floresacton/usb-can/pcb/usb-can.kicad_pcb

## KiCad design pcb/usb-can.kicad_pcb (2025-09-29)

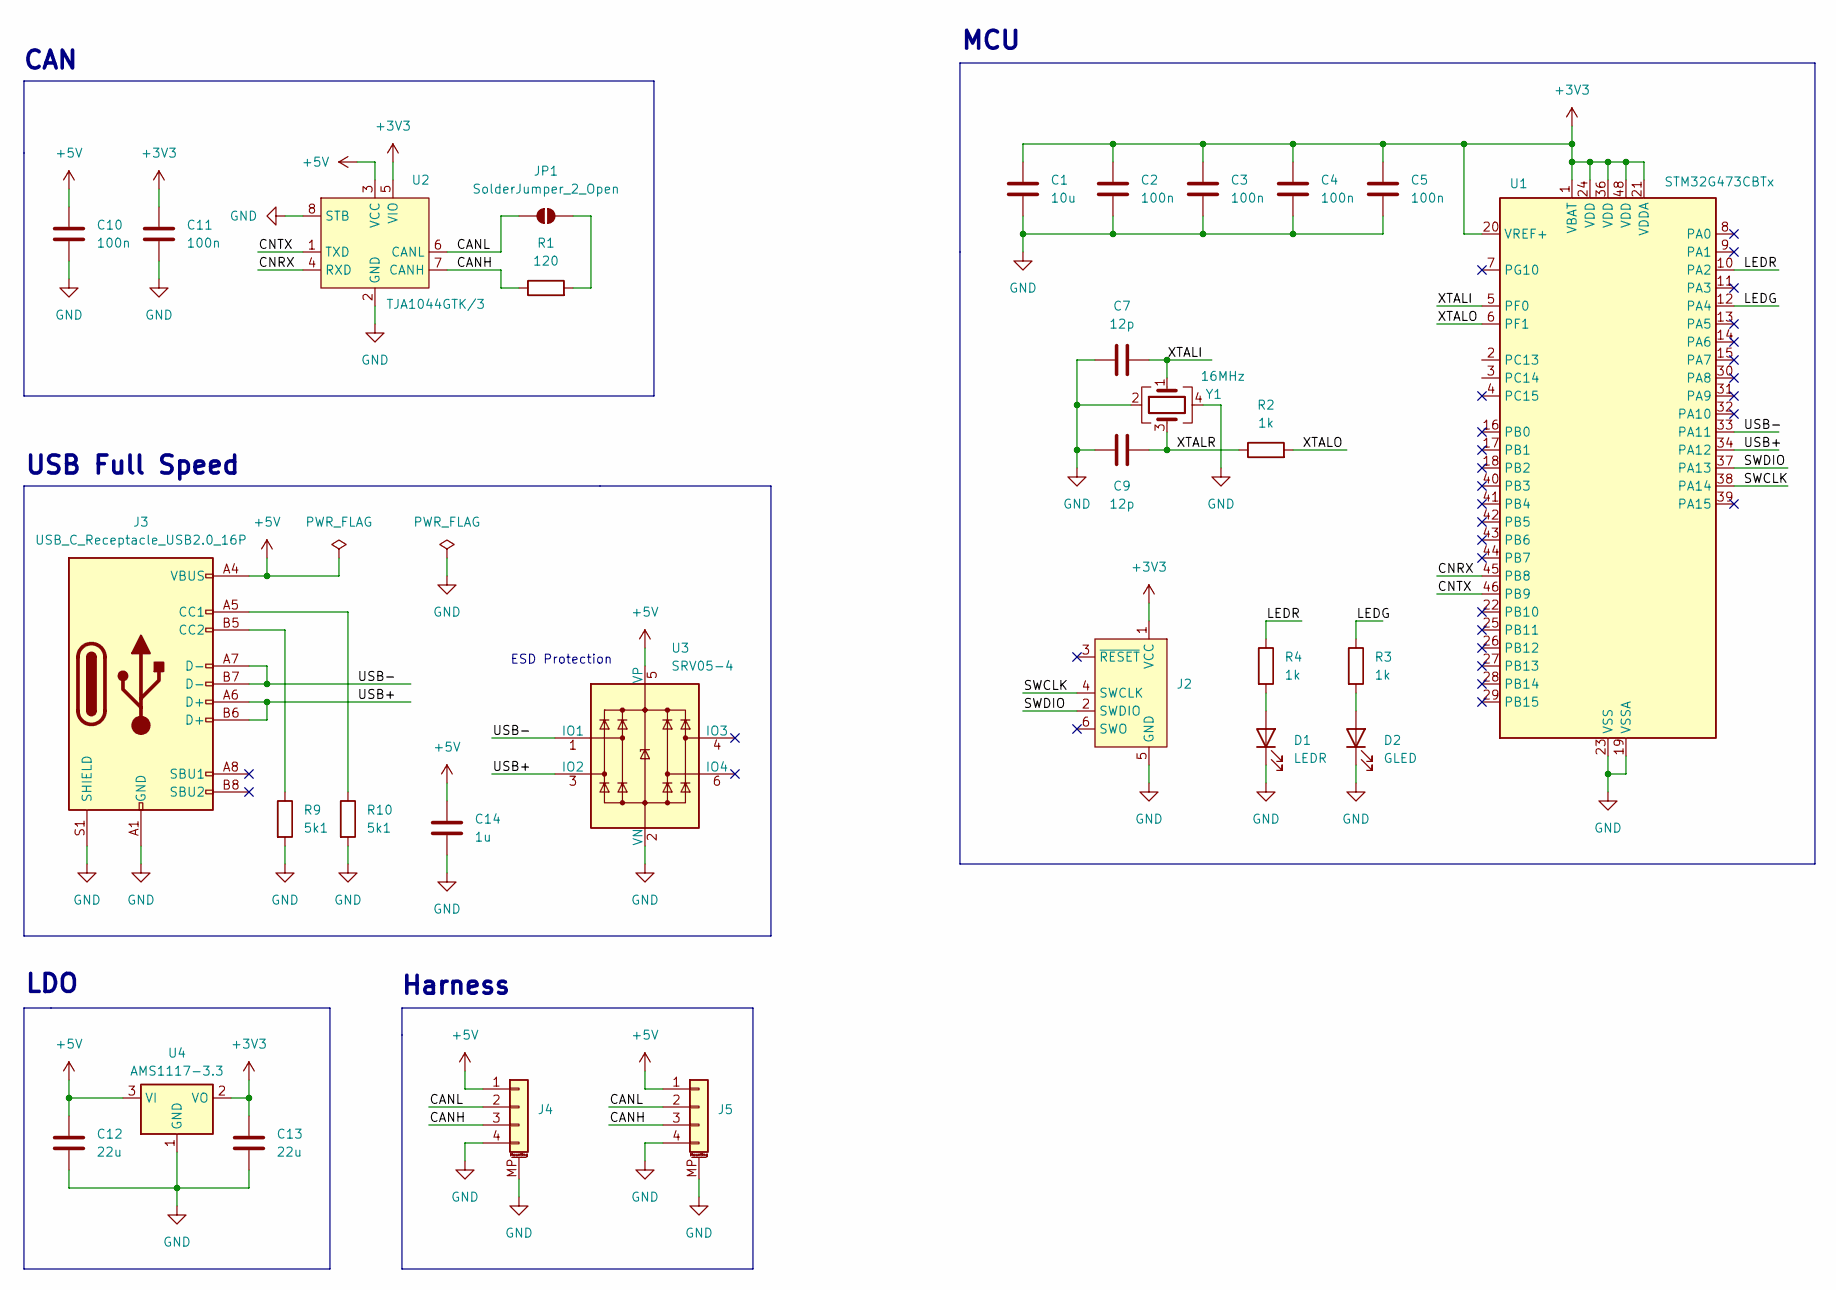
[picture p1: schematic usb-can.kicad_sch]

Parts:
C1: 10u; C_0402_1005Metric; LCSC C15525
C2, C3, C4, C5, C10, C11: 100n; C_0402_1005Metric; LCSC C1525
C7, C9: 12p; C_0402_1005Metric; LCSC C1547
C12: 22u; C_0805_2012Metric; LCSC C45783
C13: 22u; C_0603_1608Metric; LCSC C59461
C14: 1u; C_0402_1005Metric; LCSC C52923
D1: LEDR; LED_0603_1608Metric; LCSC C2286
D2: GLED; LED_0603_1608Metric; LCSC C72043
J2: Conn_ARM_SWD_TagConnect_TC2030-NL; Tag-Connect_TC2030-IDC-NL_2x03_P1.27mm_Vertical
J3: USB_C_Receptacle_USB2.0_16P; USB_C_Receptacle_GCT_USB4105-xx-A_16P_TopMnt_Horizontal; LCSC C2765186
J4, J5: Conn_01x04_MountingPin; JST_GH_SM04B-GHS-TB_1x04-1MP_P1.25mm_Horizontal; LCSC C189895
JP1: SolderJumper_2_Open; SolderJumper-2_P1.3mm_Open_RoundedPad1.0x1.5mm
R1: 120; R_1206_3216Metric; LCSC C17909
R2, R3, R4: 1k; R_0402_1005Metric; LCSC C11702
R9, R10: 5k1; R_0402_1005Metric; LCSC C25905
U1: STM32G473CBTx; LQFP-48_7x7mm_P0.5mm; LCSC C730111
U2: TJA1044GTK/3; HVSON-8-1EP_3x3mm_P0.65mm_EP1.6x2.4mm; LCSC C2157795
U3: SRV05-4; SOT-23-6; LCSC C7420376
U4: AMS1117-3.3; SOT-223-3_TabPin2; LCSC C6186
Y1: 16MHz; Crystal_SMD_3225-4Pin_3.2x2.5mm; LCSC C13738

Connections:
+3V3: C1.1, C2.1, C3.1, C4.1, C5.1, C11.1, C13.1, J2.1 (VCC), U1.1 (VBAT), U1.20 (VREF+), U1.21 (VDDA), U1.24 (VDD), U1.36 (VDD), U1.48 (VDD), U2.5 (VIO), U4.2 (VO)
+5V: C10.1, C12.1, C14.1, J3.A4 (VBUS), J3.A9 (VBUS), J3.B4 (VBUS), J3.B9 (VBUS), J4.1, J5.1, U2.3 (VCC), U3.5 (VP), U4.3 (VI)
/CANH: J4.3, J5.3, R1.1, U2.7 (CANH)
/CANL: J4.2, J5.2, JP1.1 (A), U2.6 (CANL)
/CNRX: U1.45 (PB8), U2.4 (RXD)
/CNTX: U1.46 (PB9), U2.1 (TXD)
/LEDG: R3.1, U1.12 (PA4)
/LEDR: R4.1, U1.10 (PA2)
/SWCLK: J2.4 (SWCLK), U1.38 (PA14)
/SWDIO: J2.2 (SWDIO), U1.37 (PA13)
/USB+: J3.A6 (D+), J3.B6 (D+), U1.34 (PA12), U3.3 (IO2)
/USB-: J3.A7 (D-), J3.B7 (D-), U1.33 (PA11), U3.1 (IO1)
/XTALI: C7.2, U1.5 (PF0), Y1.1
/XTALO: R2.2, U1.6 (PF1)
/XTALR: C9.2, R2.1, Y1.3
GND: C1.2, C2.2, C3.2, C4.2, C5.2, C7.1, C9.1, C10.2, C11.2, C12.2, C13.2, C14.2, D1.1 (K), D2.1 (K), J2.5 (GND), J3.A1 (GND), J3.A12 (GND), J3.B1 (GND), J3.B12 (GND), J3.S1 (SHIELD), J4.4, J4.MP (MountPin), J5.4, J5.MP (MountPin), R9.2, R10.2, U1.19 (VSSA), U1.23 (VSS), U1.35 (VSS), U1.47 (VSS), U2.2 (GND), U2.8 (STB), U2.9 (EPAD), U3.2 (VN), U4.1 (GND), Y1.2, Y1.4
unnamed: D1.2 (A), R4.2
unnamed: D2.2 (A), R3.2
unnamed: J3.A5 (CC1), R10.1
unnamed: J3.B5 (CC2), R9.1
unnamed: JP1.2 (B), R1.2

Notes on the sheet:
ESD Protection
MCU
LDO
CAN
Harness
USB Full Speed

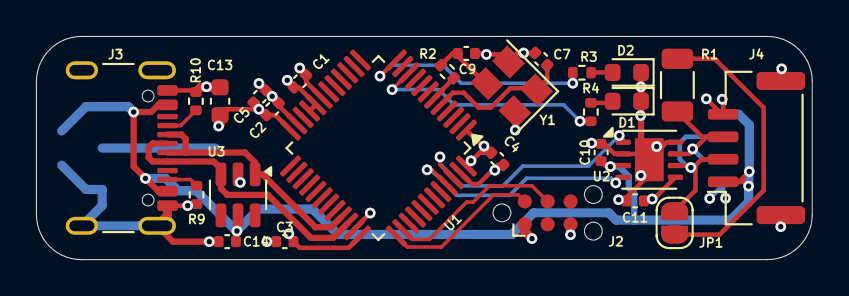
[picture p2: board usb-can.kicad_pcb from above]

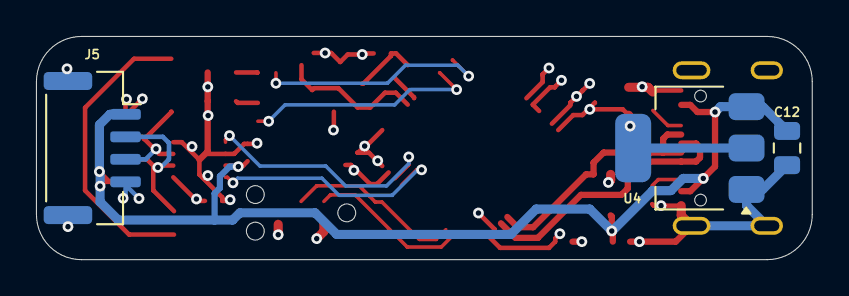
[picture p3: board usb-can.kicad_pcb from below]

Board: 4 copper layers, 43.1 x 12.4 mm, 30 parts (3 on the bottom side), 21 nets.
