floresacton/usb-can/firmware/usb-can/usb-can.ioc

Mcu.UserName=STM32G473CBTx
PA11.Signal=USB_DM
PA12.Signal=USB_DP
PA13.Signal=SYS_JTMS-SWDIO
PA14.Signal=SYS_JTCK-SWCLK
PA2.GPIO_Label=LEDR
PA2.Signal=GPIO_Output
PA4.GPIO_Label=LEDG
PA4.Signal=GPIO_Output
PB8-BOOT0.Signal=FDCAN1_RX
PB9.Signal=FDCAN1_TX
PF0-OSC_IN.Signal=RCC_OSC_IN
PF1-OSC_OUT.Signal=RCC_OSC_OUT
