floresacton/usb-can/firmware/usb-can-robstride/Core/Inc/main.h

#define LEDR_Pin GPIO_PIN_2
#define LEDR_GPIO_Port GPIOA
#define LEDG_Pin GPIO_PIN_4
#define LEDG_GPIO_Port GPIOA
