floresacton/usb-can/(commit log)

2024-06-26 Transfer project
    [bom.csv, designators.csv, positions.csv, usb-can.kicad_pcb, usb-can.kicad_sch]
2024-07-17 Send and receive dynamic sized frames
2024-07-17 Change status led function
2024-10-14 Minimize schematic
    [usb-can.kicad_sch]
2024-12-11 Finish rev2
    [bom.csv, designators.csv, positions.csv, usb-can.kicad_pcb, usb-can.kicad_sch]
2025-09-29 Update to kicad 9
    [usb-can.kicad_pcb]
